PLANET-Qdeveloper/space-balloon-ground-station/README.md

# space-balloon-ground-station  
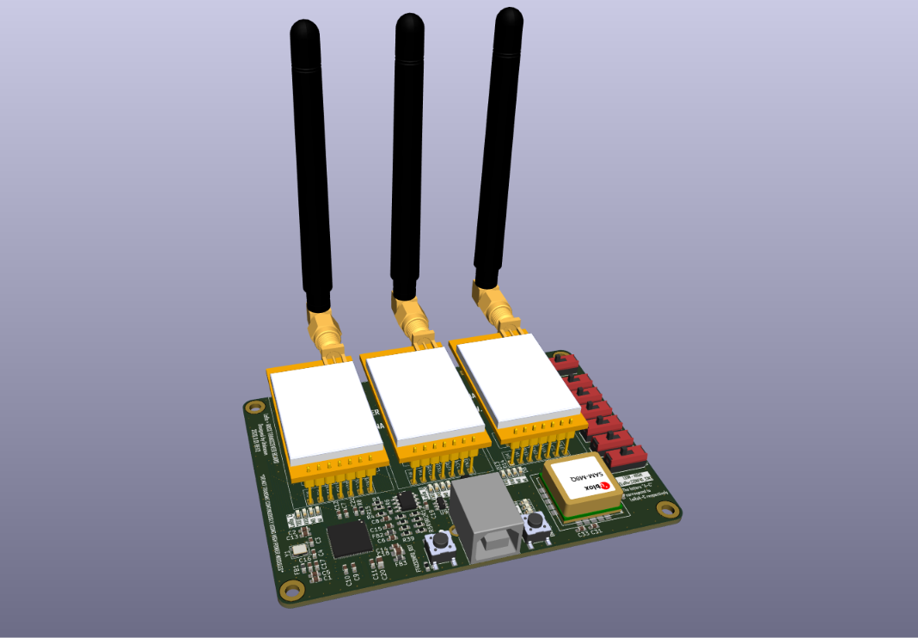
[picture p1: images/overall.png]
overall
  
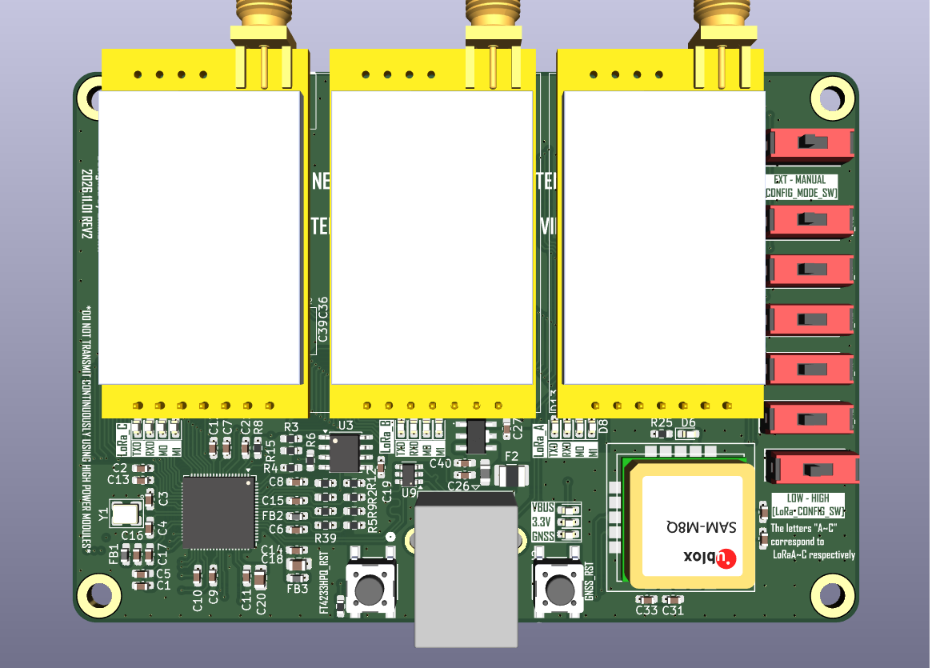
[picture p2: images/front.png]
front
  
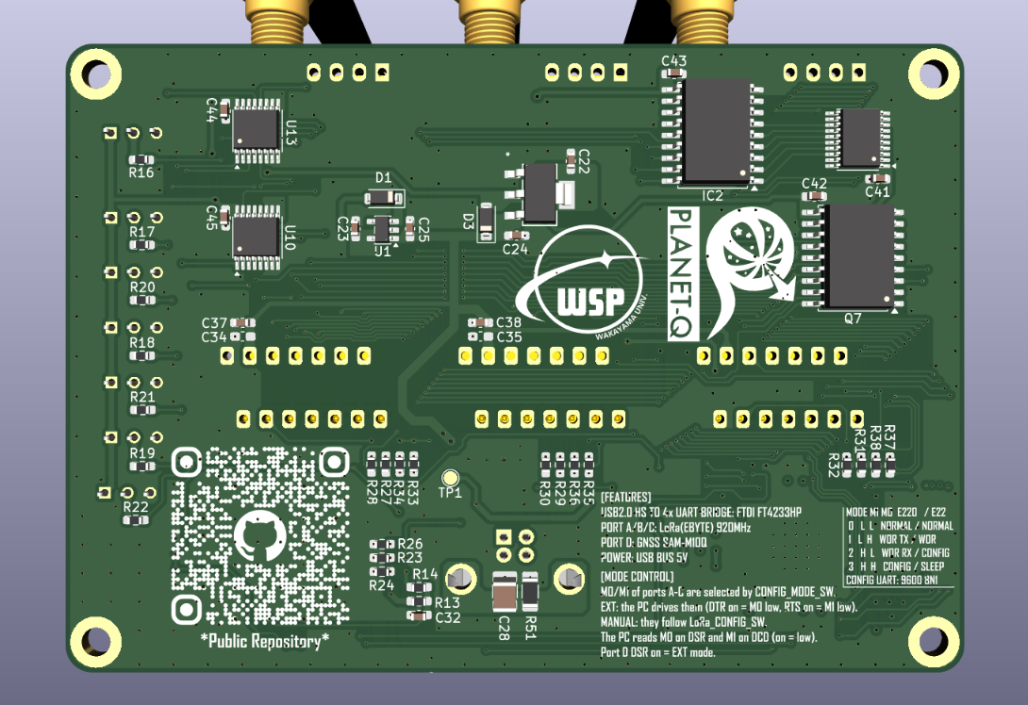
[picture p3: images/back.png]
back
