PLANET-Qdeveloper/space-balloon-ground-station/hardware/LoRa+GNSS_Transceiver_Board_REV2/bom/GroundStation_3.csv

Reference | Qty | Value | DNP | Exclude from BOM | Exclude from Board | Footprint | Datasheet
C1 | 1 | 3.3u |  |  |  | Capacitor_SMD:C_0603_1608Metric_Pad1.08x0.95mm_HandSolder
C2,C5,C6,C7,C8,C9,C10,C11,C12,C13,C14,C15,C17,C19,C21,C26,C27,C29,C30,C31,C32,C37,C38,C39,C41,C42,C43,C44,C45 | 29 | 0.1u |  |  |  | Capacitor_SMD:C_0603_1608Metric_Pad1.08x0.95mm_HandSolder
C3,C4 | 2 | 27p（C0G/NP0） |  |  |  | Capacitor_SMD:C_0603_1608Metric_Pad1.08x0.95mm_HandSolder
C16,C33 | 2 | 10u |  |  |  | Capacitor_SMD:C_0603_1608Metric_Pad1.08x0.95mm_HandSolder
C18,C20 | 2 | 10u |  |  |  | Capacitor_SMD:C_0805_2012Metric_Pad1.18x1.45mm_HandSolder
C22,C23,C24,C25,C40 | 5 | 1u |  |  |  | Capacitor_SMD:C_0603_1608Metric_Pad1.08x0.95mm_HandSolder
C28 | 1 | 1206AC472KAZ1A |  |  |  | Capacitor_SMD:C_1210_3225Metric_Pad1.33x2.70mm_HandSolder
C34,C35,C36 | 3 | 10u | 未実装(DNP) |  |  | Capacitor_SMD:C_0603_1608Metric_Pad1.08x0.95mm_HandSolder
D1,D3 | 2 | MA10EB045 |  |  |  | Diode_SMD:D_SOD-123
D2,D4,D5,D6,D7,D8,D9,D10,D11,D12,D13,D14,D15,D16,D17,D18 | 16 | LED_Small |  |  |  | LED_SMD:LED_0603_1608Metric_Pad1.05x0.95mm_HandSolder
F2 | 1 | 1210L300SLWR |  |  |  | Fuse:Fuse_1210_3225Metric_Pad1.42x2.65mm_HandSolder
FB1,FB2,FB3 | 3 | BLM18AG601SN1D |  |  |  | Inductor_SMD:L_0603_1608Metric_Pad1.05x0.95mm_HandSolder
FB4 | 1 | MI0805K601R-10 |  |  |  | Inductor_SMD:L_0805_2012Metric_Pad1.05x1.20mm_HandSolder
IC1 | 1 | XC8114AA01PR-G |  |  |  | Unknown:XC6901D901PRG | https://product.torexsemi.com/system/files/series/xc8114.pdf
IC2 | 1 | TBD62384AFWG |  |  |  | Package_SO:SOIC-18W_7.5x11.6mm_P1.27mm | https://toshiba.semicon-storage.com/info/docget.jsp?did=58146&prodName=TBD62384AFWG
J2 | 1 | USB_B |  |  |  | Connector_USB:USB_B_OST_USB-B1HSxx_Horizontal
Q7 | 1 | TBD62083AFWG |  |  |  | Package_SO:SOIC-18W_7.5x11.6mm_P1.27mm | https://toshiba.semicon-storage.com/eu/semiconductor/product/linear-ics/transistor-arrays/detail.TBD62083AFWG.html
R2,R9,R10,R11,R12 | 5 | 1M |  |  |  | Resistor_SMD:R_0603_1608Metric_Pad0.98x0.95mm_HandSolder
R3,R4,R8,R14,R15,R16 | 6 | 10k |  |  |  | Resistor_SMD:R_0603_1608Metric_Pad0.98x0.95mm_HandSolder
R5 | 1 | 12k |  |  |  | Resistor_SMD:R_0603_1608Metric_Pad0.98x0.95mm_HandSolder
R6,R17,R18,R19,R20,R21,R22 | 7 | 2.2k |  |  |  | Resistor_SMD:R_0603_1608Metric_Pad0.98x0.95mm_HandSolder
R7,R13,R27,R28,R29,R30,R31,R32,R33,R34,R35,R36,R37,R38 | 14 | 1k |  |  |  | Resistor_SMD:R_0603_1608Metric_Pad0.98x0.95mm_HandSolder
R23,R24,R25,R26 | 4 | 500 |  |  |  | Resistor_SMD:R_0603_1608Metric_Pad0.98x0.95mm_HandSolder
R39 | 1 | 15k |  |  |  | Resistor_SMD:R_0603_1608Metric_Pad0.98x0.95mm_HandSolder
R40 | 1 | 100k |  |  |  | Resistor_SMD:R_0603_1608Metric_Pad0.98x0.95mm_HandSolder
R51 | 1 | PTN1206E1004BST1 |  |  |  | Resistor_SMD:R_1206_3216Metric_Pad1.30x1.75mm_HandSolder
S1,S2,S3,S4,S5,S6,S7 | 7 | SS12SDP2 |  |  |  | Unknown:SS12SDP2 | https://www.nkkswitches.com/pdf/SSnonilluminated.pdf
SW1,SW2 | 2 | PTS645SK50SMTR92LFS |  |  |  | Unknown:SW4_PTS645SK50SMTR92LFS_CNK | PTS645SK50SMTR92LFS
TP1 | 1 | TestPoint |  |  |  | TestPoint:TestPoint_Pad_D1.5mm
U1 | 1 | ADP151AUJZ-3.3 |  |  |  | Package_TO_SOT_SMD:TSOT-23-5 | https://akizukidenshi.com/goodsaffix/ADP151_jp.pdf
U2 | 1 | FT4233HPQ-REEL |  |  |  | Package_DFN_QFN:QFN-76-1EP_9x9mm_P0.4mm_EP5.81x6.31mm
U3 | 1 | 93LCxxB |  |  |  | Package_SO:SOIC-8_3.9x4.9mm_P1.27mm | http://ww1.microchip.com/downloads/en/DeviceDoc/20001749K.pdf
U4 | 1 | SN74HCT245PWR |  |  |  | Package_SO:TSSOP-20_4.4x6.5mm_P0.65mm | https://www.ti.com/lit/ds/symlink/sn74hct245.pdf
U5,U6,U7 | 3 | E22-900T30D_E220-900T22S(JP)_versatile |  |  |  | Unknown:E22-900T30D_E220-900T22S(JP)_versatile
U8 | 1 | SAM-M10Q-00B |  |  |  | Unknown:SAM-M10Q(Hand_Solder) | SAM-M10Q-00B
U9 | 1 | USBLC6-2SC6 |  |  |  | Package_TO_SOT_SMD:SOT-23-6 | https://www.st.com/resource/en/datasheet/usblc6-2.pdf
U10,U13 | 2 | DG4053EEQ-T1-GE3 |  |  |  | Package_SO:TSSOP-16_4.4x5mm_P0.65mm | https://www.vishay.com/docs/69685/dg4051e.pdf
U11 | 1 | ADP3338AKCZ-3.3 |  |  |  | Unknown:SOT-223_DIO | https://akizukidenshi.com/goodsaffix/ADP3338_jp.pdf
Y1 | 1 | FA-238V_12.0000MA-C5 |  |  |  | Crystal:Crystal_SMD_SeikoEpson_FA238V-4Pin_3.2x2.5mm | https://akizukidenshi.com/goodsaffix/FA238V_series.pdf
