PLANET-Qdeveloper/space-balloon-ground-station/(list of files, cad)

Other CAD files:
hardware/Base_Board_CM5/3dmodel/CM5-DUAL-ETH-4G 5G-BASE.step
hardware/LoRa+GNSS_Transceiver_Board_REV2/3dmodel/GroundStation_3.step
