PLANET-Qdeveloper/space-balloon-ground-station/hardware/Base_Board_CM5/schematic/CM5-DUAL-ETH-4G_5G-BASE-Sch.pdf

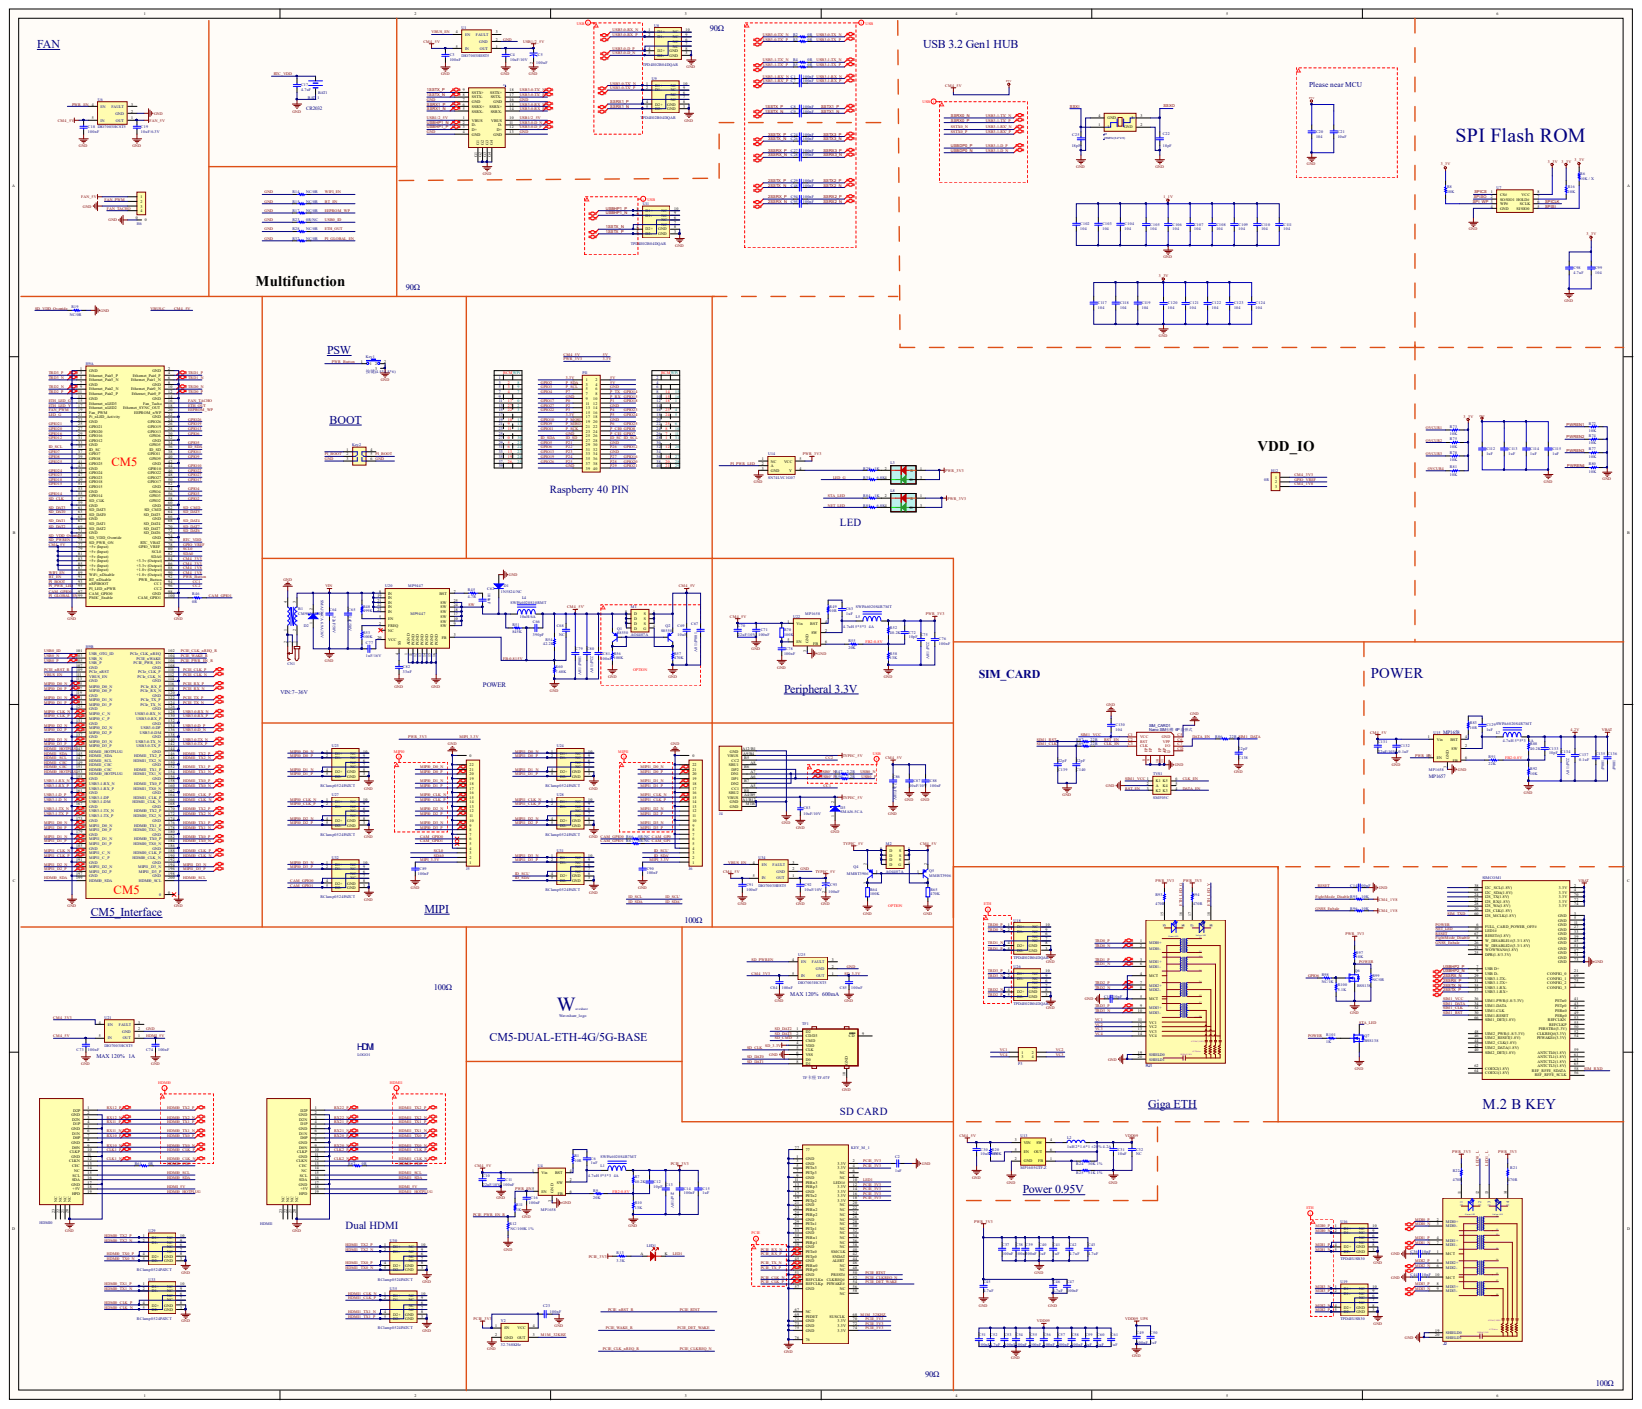
[picture p5: page 1]
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
