PLANET-Qdeveloper/space-balloon-ground-station/(commit log)

2026-10-28 add new datasheets and 3D models for hardware components
    [CM5-DUAL-ETH-4G 5G-BASE.step, CM5R5-3dsteps.step, GroundStation_3.kicad_pcb, GroundStation_3.kicad_sch]
2026-11-01 Update schematic and pcb
    [GroundStation_3.kicad_pcb, GroundStation_3.kicad_sch]
2026-11-04 Add GND plane
    [GroundStation_3.kicad_pcb, GroundStation_3.kicad_sch]
2026-11-04 Add 3dmodel and production files
    [GroundStation_3-B_Cu.gbr, GroundStation_3-B_Mask.gbr, GroundStation_3-B_Paste.gbr, GroundStation_3-B_Silkscreen.gbr, GroundStation_3-Edge_Cuts.gbr, GroundStation_3-F_Cu.gbr, GroundStation_3-F_Mask.gbr, GroundStation_3-F_Paste.gbr]
2026-11-04 Add description on the PCB
    [GroundStation_3-B_Cu.gbr, GroundStation_3-B_Mask.gbr, GroundStation_3-B_Paste.gbr, GroundStation_3-B_Silkscreen.gbr, GroundStation_3-Edge_Cuts.gbr, GroundStation_3-F_Cu.gbr, GroundStation_3-F_Mask.gbr, GroundStation_3-F_Paste.gbr]
2026-11-04 Add bom.html
2026-11-04 Add team logo on the PCB
    [GroundStation_3-B_Cu.gbr, GroundStation_3-B_Mask.gbr, GroundStation_3-B_Paste.gbr, GroundStation_3-B_Silkscreen.gbr, GroundStation_3-Edge_Cuts.gbr, GroundStation_3-F_Cu.gbr, GroundStation_3-F_Mask.gbr, GroundStation_3-F_Paste.gbr]
2026-11-09 Add BOM csv
    [GroundStation_3.kicad_sch]
2026-11-09 Change .gitignore and add bom.csv
    [GroundStation_3.csv]
